TANC-security/keypad-firmware/(threads)

Thread 1 (2018-05-23):

Recomendations for update to alta_veesta.ino

wax72, 2018-05-23:
Attached file is a recomended update to the INO from the May 21st file posted.
- Added (F to every Seriel.print strings possible.
- Added a #ifdef DEBUG around the print unkown char code as that is really only needed in debug and not required for normal operations that I can see and just clutters the console.

[alta_veesta.zip](https://github.com/TANC-security/keypad-firmware/files/2029540/alta_veesta.zip)

markkimsal, 2018-05-23:
Thanks for the F() statements, but I won't be able to merge them for a while.

The unknown chars is a borderline error condition.  Yeah, they're not useful, but they represent a flaw in the system that I feel should be known whether or not you are debugging.  They shouldn't be cluttering up the console too much, but also they are json so a script can easily ignore type=='unknown'

Thread 4 (2018-05-24):

Software Serial Interupts

wax72, 2018-05-24:
Have a question regarding the Pin Change Interupt.   That code seems to be there for the Software Serial which I am not really familiar with.  Trying to use the WiFi101 shield and it is tripping up on that section of code.  If I remove this code section, the code will compile with the WiFi101.H library but the messaging to the panel stops.
If I leave this section in and I add the WiFi101.H library, the compiler failes. Looking at the errors online, this is a known issue with Software Serial and WiFi101.  Could not see any workaround to make this work and I really do not know anything about the code section below.   I am assuming this code is fixed and has to stay and I will not be able to work with the WiFi101 shiled but would like your comment on that if that is true.

//Pin Change INTerrupts
#if defined(PCINT0_vect)
ISR(PCINT0_vect)
{
  on_pin_change();
}
#endif

#if defined(PCINT1_vect)
ISR(PCINT1_vect, ISR_ALIASOF(PCINT0_vect));
#endif

#if defined(PCINT2_vect)
ISR(PCINT2_vect, ISR_ALIASOF(PCINT0_vect));
#endif

#if defined(PCINT3_vect)
ISR(PCINT3_vect, ISR_ALIASOF(PCINT0_vect));
#endif

markkimsal, 2018-06-01:
These are just grabbing all the available interrupts so that any pin can be used for the software serial and the tx and rx can be changed in the config.h.

> ISR (PCINT0_vect) pin change interrupt for D8 to D13
> ISR (PCINT1_vect) pin change interrupt for A0 to A5
> ISR (PCINT2_vect) pin change interrupt for D0 to D7

https://playground.arduino.cc/Main/PinChangeInterrupt

Wifi101 needs SPI so pins 10-13.  Comment out the PCINT0_vect and make all the ALAISOF point to 1.

Then change the rx/tx pins in config.h

I guess these could be moved to config.h with more documentation and comments.

Closed 2018-05-31.

Thread 5 (2018-05-31):

Display Message Dropping first Char

wax72, 2018-05-31:
I am stumped on this one and it is driving me bonkers.
Trying to capture the text going to the display and sending that to a String
For some reason the first letter of the display message will drop.  Let that same message loop and after a while then I start getting the first letter again.  New message will come and drop the first letter of the display message and then it will come back if that same message loops.
Example
Display message in the JSON shows "ARMED ***AWAY***May Exit Now  01"
When I capture that to string I get "RMED ***AWAY***May Exit Now  01"
or
JSON message "FAULT 01"
String gets "AULT 01"
Let that message stay and after 5 or so repeats my string will get "FAULT 01"

Here is my modified code.  The JSON is commented out and replaced with my String.   If I left the JSON in as well I would always see the first letter of the display message.  The Display1 string also drops the first letter as well and will get it after a few repeats like the OutStr
```
String OutStr = "D";
for (int x = 0; x <= 10 ; x++) {
    switch ( x ) {
case 6:
                if ( (cbuf[x] & BIT_MASK_BYTE1_BEEP ) > 0 ) {
                    //Serial.print(F(","));
                    //Serial.print(F(" \"beep\": \""));
                    //print_hex( cbuf[x], 8);
                    //Serial.print(F("\""));
                    OutStr += "T";
                }else{
                    OutStr += "F";
                }
                break;
            case 7:
                //Serial.print(sep);
                if ( (cbuf[x] & BIT_MASK_BYTE2_ARMED_HOME ) ) {
                    //Serial.print(F("\"ARMED_STAY\": true"));
                    OutStr += "T";
                }else{
                    //Serial.print(F("\"ARMED_STAY\": false"));
                    OutStr += "F";
                }
                if ( (cbuf[x] & BIT_MASK_BYTE2_LOW_BAT ) ) {
                    //Serial.print(sep);
                    //Serial.print(F("\"low_batt\": true"));
                    OutStr += "T";
                }else{
                    OutStr += "F";
                }

                //Serial.print(sep);
                if ( (cbuf[x] & BIT_MASK_BYTE2_READY )) {
                    //Serial.print(F("\"READY\": \"true\""));
                    OutStr += "T";
                } else {
                    //Serial.print(F("\"READY\": \"false\""));
                    OutStr += "F";
                }
                break;
            case 8:
				        //Serial.print(sep);
                if ( (cbuf[x] & BIT_MASK_BYTE3_CHIME_MODE ) ) {
                    //Serial.print(F("\"chime\": \"on\""));
                    OutStr += "T";
                } else {
                    //Serial.print(F("\"chime\": \"off\""));
                    OutStr += "F";
                }

                if ( (cbuf[x] & BIT_MASK_BYTE3_BYPASS ) ) {
					          //Serial.print(sep);
                    //Serial.print(F("\"bypass_zone\": true"));
                    OutStr += "T";
                }else{
                    OutStr += "F";
                }

				        //Serial.print(sep);
                if ( (cbuf[x] & BIT_MASK_BYTE3_AC_POWER ) ) {
                    //Serial.print(F("\"ac_power\": \"on\""));
                    OutStr += "T";
                } else {
                    //Serial.print(F("\"ac_power\": \"off\""));
                    OutStr += "F";
                }

				        //Serial.print(sep);
                if ( (cbuf[x] & BIT_MASK_BYTE3_ARMED_AWAY ) > 0 ) {
                    //Serial.print(F("\"ARMED_AWAY\": true"));
                    OutStr += "T";
                } else {
                    //Serial.print(F("\"ARMED_AWAY\": false"));
                    OutStr += "F";
                }
                break;
            case 10:
                if ( cbuf[x] != 0x00 ) {
					        //Serial.print(sep);
                  //Serial.print(F("\"prompt_pos\": \""));
                  //Serial.print( (int)cbuf[x] );
                  //print_hex( cbuf[x], 8);
                  //Serial.print(F("\""));
                }

                break;
            }
	}
	//Serial.print(sep);
	//Serial.print(F("\"msg\": \""));
  OutStr += ":";
	for (int x = 12; x < *idx -1; x++) {
		if ((int)cbuf[x] < 32 || (int)cbuf[x] > 126) {
		    //don't print non printable ascii
		} else {
			//Serial.print(cbuf[x]);
      if(MSGcnt < 16){
        Display1 = Display1 + cbuf[x];
        _**OutStr += cbuf[x];**_
        MSGcnt++;
      }else if(MSGcnt>15 && MSGcnt<32){
        Display2 = Display2 + cbuf[x];
        **_OutStr += cbuf[x];_**
        MSGcnt++;
      }
		}
		//TODO: fix timing
		//this is because there's a timing bug and we get an extra
		//1 bit in the most significant position
		if (cbuf[x] & 0x80) {
			cbuf[x] = cbuf[x] ^ 0x80;
			//Serial.print( cbuf[x] );
		}
	}
	//Serial.println(F("\"}"));

  //Outdata Data to Serial
  Serial.println(OutStr);
```

markkimsal, 2018-06-01:
Can you append to SoutStr when the cbuf is out of ASCII range?  It could be a timing issue and the first character is either lower than 32 or above 126 because the value of the bits is shifted to the right or left one place.

If you disable the wifi shield part of the code does this still happen?  (could be some kind of interrupt collision)

wax72, 2018-06-01:
Here is the strange part, Serial.print(cbuf[x]) prints the character just fine.  In the sample below, the Serial.println prints the first char to the console just fine like the F in FAULT but the display and outstr stings drops the first letter for the first 5 messages and then gets the letter after a while.  It has to be a timing issue but no clue why cbuf would print to console and not to string for the first letter.  I have all the network/Wifi removed and nothing else added but base code.  Even the LRR is commented out.
 if(MSGcnt < 16){
        Serial.print(cbuf[x]);   // This Works and prints to console
        Display1 = Display1 + cbuf[x];  //First letter will drop
          OutStr += cbuf[x];
        MSGcnt++;
      }else if(MSGcnt>15 && MSGcnt<32){
        Serial.print(cbuf[x]);
        Display2 = Display2 + cbuf[x];
        OutStr += cbuf[x];
        MSGcnt++;
      }

markkimsal, 2018-06-02:
It might be low memory.  But, not sure why it would fix itself after a while.

You could try using `String::reserve(int size)` to allocate enough memory for the final string right away.

```
String Display = "";
Display.reserve(45);
```

Something like that might reduce fragmentation.

If you're able to `Serial.print(cbuf[x])` then it is not a timing problem.  I don't know what it is, but it's probably a low-memory / String class problem.

Why bother with String concats?  If `Serial.print()` works, then just use it.

wax72, 2018-06-02:
Arghh.  Removed the concat string and did straight up Serial.print(cbuf[x]); and I am still dropping the firs letter of the message for the first 4 repeats and get the first letter on the 5th message repeat.  Seems consistent with tht 5th messgae.  Change in message always resets that back to 1 and drops the first letter.   Back to some sort of timing issue I need to track down.

wax72, 2018-06-04:
And the problem is in the Serial Console as well so not just a problem with the serial COM to the second network arduino.  At this point I am closing this issue as I put in hours trying to figure this one out.   I am just going to handle it with the http post to the web API and add the missing letter since it is predictable based on the message.

wax72, 2018-06-04:
So I had to give it one last go and what I found was cbuf[12] the first char in display message was getting the wrong value so the filter in the message out put was filtering it out.
" "  found dec -96 should be 32
"A" found dec -63 should be 65
"D" found dec -60 should be 68
"F" found dec -58 should be 70
So I added this to solve the problem.  Not sure why the char is getting invalid characters sometimes but it is always consistent in the invalid char so I am able to replace it.
if(cbuf[12] == -96){
    cbuf[12] = 32;
  }else if(cbuf[12] == -58){
    cbuf[12] = 70;
  }else if(cbuf[12] == -63){
    cbuf[12] = 65;
  }else if(cbuf[12] == -60){
    cbuf[12] = 68;
  }

wax72, 2018-06-04:
I guess I could have also done it cbuf[12] = cbuf[12] +128 as it shifted down by 128

markkimsal, 2018-06-04:
128 is 0x80

This code snippet tries to remove the highest bit if it is 1.  For me, this only happened to the first character of the second line of text.
```
        //1 bit in the most significant position
        if (cbuf[x] & 0x80) {
            cbuf[x] = cbuf[x] ^ 0x80;                                                                                                                         
            Serial.print( cbuf[x] );
        }
```

wax72, 2018-06-04:
I saw that bit of code and that was on bit 10 but my issue is on bit 11 so I ignored that but I did have that bit of code removed as I was not sure what it was doing but I am going to put that back in.

Closed 2018-06-04.

Thread 6 (2018-06-02):

Overlapping messages

wax72, 2018-06-02:
On occasion the Serial.read() on my network arduino would get overlapping messages from the Alarm Panel arduino on the Serial.println() when the display message and the status message were really close together on an event change like arming system.   The Serial.read() would start getting the Display message and then the Status message would cut in and would get a mixed string of display and status.  A quick fix to that was to add Serial.flush(); to the end of each Display and Status message.   So far that seems to be working great with no issues.   Just thought I would pass that along.

wax72, 2018-06-04:
Stand corrected, the serial.flush() reduced the problem but still getting a random few overlapping messages on the network arduino.  Serial console on the first alarm panel aruino is showing just fine so the problem is with the timing on the serial connection to the second arduino when the incoming alarm panel message come in too close together.  Seems to only happen on the display message but the overlapping message that cuts in could be a status message or a display message which I think is due to the display message being significantly longer.  Still researching this problem.

markkimsal, 2018-06-04:
Is the message that cuts in complete and then the original message finishes or do they intertwine?

    {F7...}{F2}{...F7}

or

    {F7...}{F2...}{...F7}{...F2}{...F7}

Thread 8 (2019-03-16):

Arduino Micro?

oxr463, 2019-03-16:
I'm looking to integrate with a Honeywell Vista 20p, and I'd like to purchase an arduino to use this firmware with.

The micro [[1]], is the smallest, least expensive model, but does it work with this firmware?

[1]: https://store.arduino.cc/usa/arduino-micro

markkimsal, 2019-03-31:
I don't see why not. It has a UART and some 5 analog pins it should work.

oxr463, 2019-03-31:
I'll order one and see what happens. If I have any issues I'll post them here.

Thread 10 (2019-03-29):

F7 CRC

KathyRayburn, 2019-03-29:
Has anyone determined the algorithm for computing F7 message CRCs? It doesn't appear to be the same as is used for the messages sent from the keypad.

Also, it appears there is some initialization that occurs when a keypad powers up. I see these messages sent out: 10 87 00 00 04 04 04 00 5D
(I'm not sure why it says 87 bytes when only 7 are available.)

Thanks to all the folks who worked on this project, it's been very helpful in emulating the panel.

markkimsal, 2019-03-31:
Tom Vickers has some projects that are the compliment of this one.  He's re-creating the panel firmware to talk to standard keypads.  So, if there's someone who knows how to create the F7 CRC, it's probably
Tom.

https://github.com/TomVickers/Arduino2keypad/blob/ef0e8f3b38f804afa7154dedb7ecaf6a09b34ee7/arduinoProj/USB2keybus/KeypadSerial.cpp

KathyRayburn, 2019-03-31:
Thanks! That's exactly what I needed.

Thread 11 (2019-04-05):

Keys not sent to panel

foodbag, 2019-04-05:
I cannot seem to get the atmega to send key commands to the panel. I can see and decode messages sent from the panel to the keypads, but the commands seem to never leave the "to panel" buffer. The TT+KPADDR command works fine and I have changed the keypad address of the atmega to be different from the other keypad attached to the Vista 20p. Any idea what is causing this? What signals from the panel does the atmega look for to send data back to the panel? Is the communication code (to send data back to the panel) sensitive the clock speed of the uC?

I am using the following:
Vista 20p panel w/ 6160RF keypad (on address 16)
Uno (or a breadboard atmega 328p running at 8Mhz, tried both)
Using transistors as described in the readme for level shifting.
Atmega keypad address = 18

Thanks for you help.

wax72, 2019-04-05:
Use Keypad Address 16 and on your IDE Serial Monitor, make sure you have Send CR on Enter enabled as you need the CR to end the command in serial monitor.  One other thing, I was only able to get the PC817 opto coupler to work.   I posted a wiring diagram on the only project https://github.com/markkimsal/homesecurity/issues/8  That x1 resistor should be a 10K pull down.

foodbag, 2019-04-05:
I've got the settings for sending commands from the computer to the arduino (since i can change the keypad address with the TT+ command). Is there any reason for using the address 16 vs others (since I usually put a real keypad on the lowest address)?

wax72, 2019-04-05:
The panel has to have that keypad address enabled. I think they usually only have the active keypads enabled so 16 being the first keypad address will work but others may or may not work depending if your panel has that address enabled. There is a command you can run to check to see what address are enabled on the keypad but cant remember what the was.   16 should work and there is no issue with your keypad on same address as the arduino.

wax72, 2019-04-05:
Here is an updated wiring diagram that works for me.
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

bokumura, 2019-04-13:
Do you really need the 1N400X diode on the output to the keypad?

wax72, 2019-04-13:
It will work without the diode but I had some strange issues on the data out so I put that in the circuit.  Not sure if it was the solution or not but left it in.

foodbag, 2019-04-17:
I was able to get it working by using a optocoupler on arduino tx to panel rx signal. Not sure why a 2n4401 works in the panel tx to arduino rx signal but not on the other. Thanks for the suggestion. It really helped me pinpoint the issue.

Closed 2019-04-17.

Thread 12 (2021-06-11):

Bitmap of open zones

alanrothenbush, 2021-06-11:
Forgive me this backhanded way of contacting you, but I have a question and this is the only way I could think of.

The short version of the question is this: Does a Honeywell panel send a list of open zones to a keypad?

Here's the long version. I have a lot of zones in my house .. a lot. I have contacts on all the doors and windows as well as the locks. (Big deal that the door is closed, is it locked?)

Problem 1 is that I have "dumb" keypads at the doors. They don't say "Garage open", they say "17", which means I also have a list of names and numbers on a piece of paper by the panels.

Problem 2 is that on a summer day, all the doors and windows are open and so my keypads spend a minute or more telling me about, as they slowly flash the open zone numbers. 11 17 13 34 4 5 9 and so on (and on and on). I can go close something and then have to wait a long time before I know it's closed. Worse, I have to remember what number it was that was closed and then wait long enough to convince myself that it's no longer in the list.

This is, quite frankly, insane, as user unfriendly as can be. DSC keypads tell you instantly that a zone is OK. The supposedly "better" Honeywell system does not.

Anyway, my plan for item 1 was an Arduino and an LCD. When the Arduino saw an F7 message with "FAULT 17" in it, the LCD would display "Garage Unlocked"

This works fine; there's just a big lookup table of fault codes and names; easy.

But problem 2 remains, the potentially LONG time before knowing that a zone is no longer open.

I was wondering if you have any reason to believe that the panel sends open zone information to the bus/keypad as a single complete message? Maybe those unknown bytes are bitmaps of zone status?

Thanks for any thoughts.

JJM-Student, 2021-06-14:
Though I am not directly involved with this project, I followed it closely while I worked [a different kind of project leveraging a home security panel](https://hackaday.io/project/153872-flood-fault-circuit-interrupter).

I think the solution presented here aids you with Problem 1 directly as it facilitates the addition of "open" panels rather than purchasing dedicated, proprietary panels for the improvement you're seeking.

However, I think there are a couple of issues brought up in Problem 1 and 2 as you defined them which might benefit from a different approach. Instead of extending the existing panel communication scheme, you may do well to directly monitor each zone in parallel with an isolated comparator circuit sitting between your microcontroller of choice and the existing panel. This system could then incorporate communication and/or control of any interface you'd choose to monitor the statuses of all your zones. You mention "a lot" of zones but perhaps quantifying that could be more helpful (32? 64? etc.). Obviously the more zones you have the less practical such a system might be (especially if you're using a remotely located zone expander and/or zone doubling on any of your existing zones). At the same time, such a solution would actually layer on the type of intelligence you might be seeking whereas the system here primarily extends the existing functionality of the traditional panel and control interface without necessarily adding other unique zone intelligence (as you may be imagining/seeking?).

In the project I referenced earlier [comparators connected an EEPROM](https://hackaday.io/project/153872-flood-fault-circuit-interrupter/log/145052-comparator-circuit-1st-revision) but a similar solution could work with a microcontroller. In case you need some guidance on comparators I'll include [a link to a decent starting guide](https://www.maximintegrated.com/en/design/technical-documents/tutorials/8/886.html).

If you have any questions on my old project feel free to start up a conversation there!

Best,
Jon

alanrothenbush, 2021-06-14:
Thanks for the time!  Excellent idea, except for the fact that most of my zones are RF zones, and I haven't found anything to read these sensors.

Mind you, I haven't looked that hard for other receivers ...

Thanks again.

Dilbert66, 2021-06-14:
The vista 20p uses a very basic protocol  and does not send much in the way of info.   The expectation is for the keypad emulation to keep track of what is currently bypassed/alarmed/faulted, etc until the panel sends another f7 to update statuses.  Closures are never announced with the panel zones.  You therefore need to setup a time to live and automatically close when this expires.

Please see my ESP8266/ESP32 ESPHOME/MQTT implemenations (based initially on this library) for an example.

https://github.com/Dilbert66/esphome-vistaECP

alan-bc, 2021-06-17:
> The vista 20p uses a very basic protocol  ...  You therefore need to setup a time to live and automatically close when this expires.

Thanks for this!

As I've said often recently, I am astonished that so BASIC a security system function .. telling me what's open .. is so very hard.  I've had a number of different security systems in my houses over the years and this is by far the dumbest.

I gave thought to a TTL in the code, but the TLL would have to be

   # of possible open zones * update rate of the panel * 2

With 30 zones in the house, that's easily 2 minutes, and that's NUTS.  I still have my very first security system, a BSR X-10 system, completely wireless, and I just checked it.  Even that old thing would update in near real time .. within a second or two.

So the current plan is a 4x40 LCD display, arranged as two columns.  That will list 8 open zones, a workable number even on a summer day with lots of windows open.  The open zones round robin, so an open zone will stay on the display for about 20 seconds until it's replaced by another open zone.  (I guess this a sort of TTL.)

This lets me read the display, run around a bit .. close this, close this, close this .. then come back and see what's still open, run around some more and so on.  Ugly, but workable, and maybe workable enough to leave in place.

(Frankly, when I had to locate an OLD Hayes modem and build a pseudo Telco interface just to talk to the panel with a computer, I started to have some doubts about these Honeywell panels ...)

Thanks again.

Dilbert66, 2021-06-17:
Actually technically, only the on board 8 panel zones would need a ttl since the other expander (4219/4229) or rf hosted zones could be monitored (via the 98/9E cmds) and updated that way since you do get open/close events immediately with those.  That's what I do anyhow.  If you really want to know the immediate access to the on panel zones, a hack is to setup a relay follower on the zones and use the relay output to detect the zone activity.

Dilbert66, 2021-06-17:
Just to clarify, the protocol we emulate is the keypad protocol which really doesnt need to know that a zone is closed. All it needs to know is which are open

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

Cmd 9e will give you all the RF zone info

alan-bc, 2021-06-18:
> Cmd 9e responses will give you all the RF zone info

Well, that sounds great, except I don't see that command in my Programming Guide.  Am I missing something?

Dilbert66, 2021-06-18:
Sorry that is in the ecp protocol. Not a system cmd

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

Thread 13 (2022-01-24):

Not sure how to simulate key presses. Please help

ComputerGuy99, 2022-01-24:
I have always wanted to create a virtual keypad for my Honeywell Vista 20P alarm system that would allow me to monitor it and program it using a computer. I found devices such as the envisalink and alarm decoder online that claim to offer such functionality, however their high cost and closed source software made me lose interest immediately. I was looking for an open source option that I could extend and modify as my needs change and grow. I came across your project very recently and after seeing the code it looked very promising so I decided to try it out. I was able to compile your code and load in onto an arduino nano and it appears to be working fine. I connected pin D12 on the arduino to the yellow wire of the keypad bus via a 5V VRM and I connected pin D11 to the green wire of the keypad bus using a diode as outlined in the instructions. When I open up the serial monitor in the Arduino GUI I see the "Starting vista keypad bus" message followed by various messages of type unknown. I a message of type display every few seconds which gives some information about the status of the system however that information often is incorrect based on the status my keypad is showing. I also receive F6 messages every minute or so of the form "kp ack addr = x" where x is always a random negative or positive number. I've tried to convert this number to decimal to see if there is any pattern but couldn't find anything. Note: I have disabled (set to zone type 0) all zones and only have the arduino and a 6150 fixed display keypad set to address 17 attached to my alarm panel. I have tried changing the address of the Arduino using TT+kpaddr= y where y is the address I want to set and this appears to be working correctly. However, I am not sure what commands I need to send in order to simulate key presses on a keypad or to change or view programing or show more detailed system status as can be seen on a 6160 or 6139 alphanumeric keypad. Any help would be appreciated. I have tried looking online and there doesn't seem to be a lot of technical information covering these alarm systems online. All I was able to find was a copy of the compass software and a pdf on another github page covering the formatting of F6 and F7 messages. I have attached screen shots of my serial monitor.
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

markkimsal, 2022-01-24:
you should be able to just write to the arduino serial any numbers between 0-9.  I think the special keys like `*` and `#` are A,B and pressing both is 'C' or 'D'.

if you have a linux/unix machine, the USB serial should be available as /dev/ttyAMA{0-9} or /dev/ttyUSB{0-9}

you might have to set the correct speed of the port with a tool like `stty`
```
stty -F $serialPort cs8 115200 ignbrk -brkint -imaxbel -opost -onlcr -isig -icanon -iexten -echo -echoe -echok -echoctl -echoke noflsh -ixon -crtscts
```
Where $serialPort is the location of the /dev/ttyAMA or /dev/ttyUSB

But, slowly typing numbers into the serial terminal of adruino IDE should cause your panel to respond.

That seems like too many unknown bytes.  I think you need a diode on the green line and some other resistors.

I seem to have lost the domain name with all the hardware docs.  I'll see if I can't throw them into a PDF or github site or something.

markkimsal, 2022-01-24:
https://github.com/TANC-security/keypad-firmware/blob/master/docs/Self-Monitoring%20_%20Notifications%20From%20Your%20Home%20Security%20System.pdf

markkimsal, 2022-01-24:
you might be able to bypass the opto couplers, but you need to somehow shift the panel's 5v voltage to 3.3v, or use a 5v arduino.  The opto couplers are powered by the arduino and isolated from the panel's voltage.  Ensure somethings are pulled to ground with some high value resistors so they're not floating.  I'm not very good at this electronics, but this is the setup that i finally got stable.  the last thing you want is a couple bits being random and getting an alarm text message sent to your phone when there's actually no problem.

ComputerGuy99, 2022-01-24:
Thank you so much for the quick reply. I will try typing raw numbers into the arduino IDE. If you could somehow share the hardware documentation you have I would really appreciate that. I tried to visit the domain and sadly it is down on my end as well

markkimsal, 2022-02-03:
I'm not a hardware or EE guy, so definitely do whatever you can to get it running.

Thread 14 (2023-01-25):

Random Characters

firealarmss, 2023-01-25:
Afternoon, I have been trying this on a few different Arduinos. Mega, UNO, and NANO. I can't get them to report any usable data. Only twice did the uno sorta work by giving the "starting vista" message but after that on bootup, it's just random characters.

firealarmss, 2023-01-25:
For more info... pin13 flashes a couple times then it sends a few random characters then it just does nothing.

firealarmss, 2023-01-25:
For more info.... Pin 13 flashes a couple of times then it sends random characters to the serial monitor then it just turns off

Closed 2023-01-31.
